NPC-jakobmoenster/Kaboom_Box/KiCad/Kaboom_box.kicad_pcb

## KiCad design KiCad/Kaboom_box.kicad_pcb (2023-12-14)

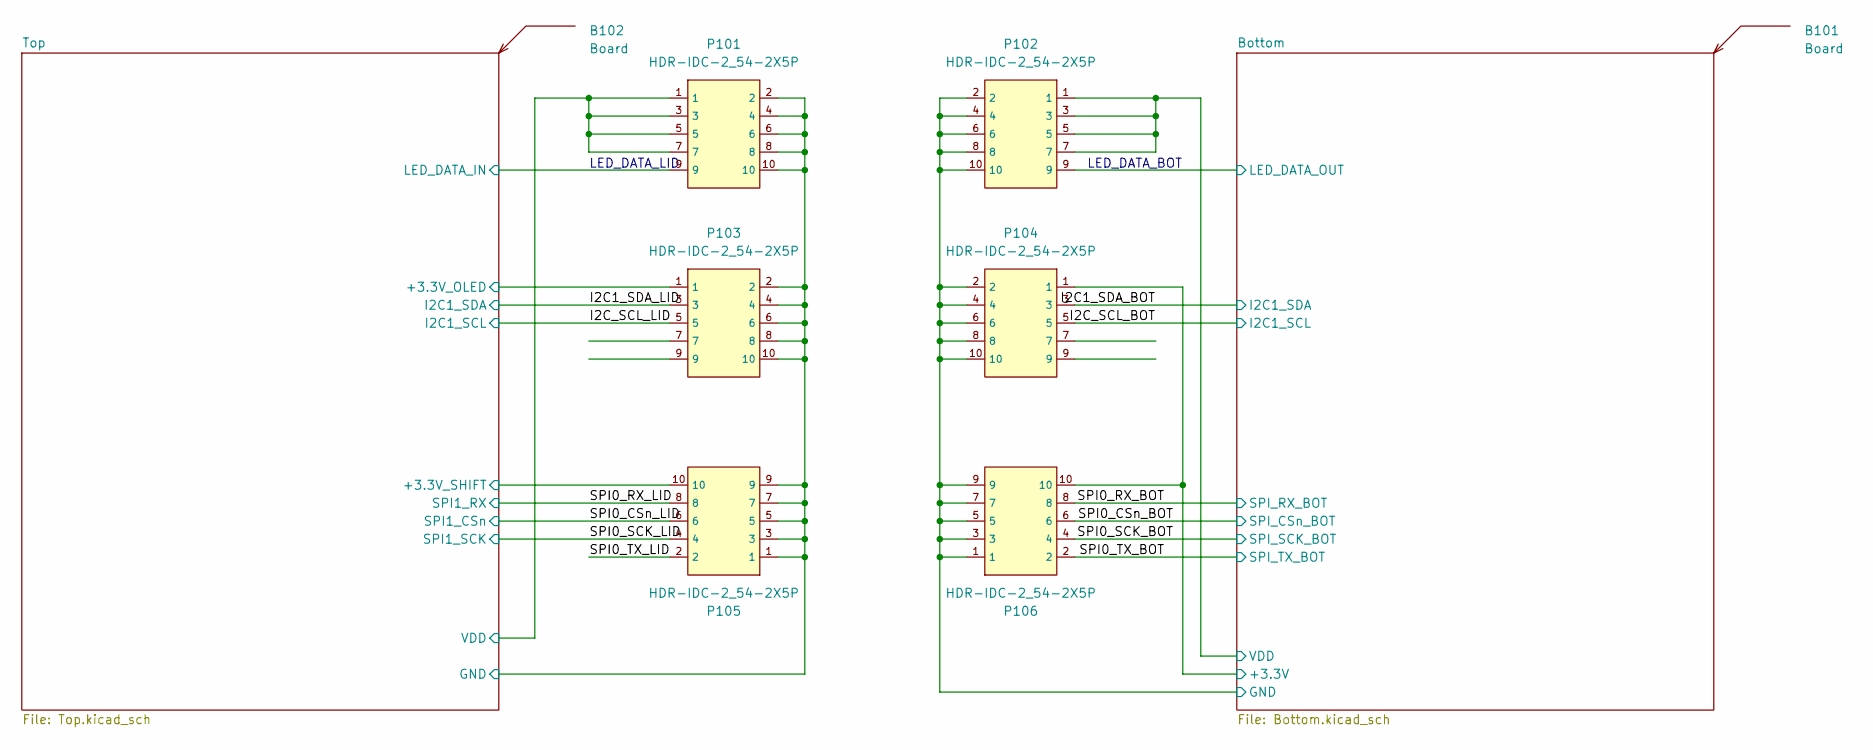
[picture p1: schematic Kaboom_box.kicad_sch]

Parts:
B101, B102: Board
P101, P102, P103, P104, P105, P106: HDR-IDC-2_54-2X5P; IDC-TH_10P-P2.54_C5665; LCSC C5665

Connections:
/Bottom/+3.3V: P104.1, P106.10; also elsewhere on the board
/Bottom/LED_DATA_OUT: P102.9; also elsewhere on the board
/Bottom/VDD: P102.1, P102.3, P102.5, P102.7; also elsewhere on the board
/I2C1_SDA_BOT: P104.3; also elsewhere on the board
/I2C1_SDA_LID: P103.3; also elsewhere on the board
/I2C_SCL_BOT: P104.5; also elsewhere on the board
/I2C_SCL_LID: P103.5; also elsewhere on the board
/SPI0_CSn_BOT: P106.6; also elsewhere on the board
/SPI0_CSn_LID: P105.6; also elsewhere on the board
/SPI0_RX_BOT: P106.8; also elsewhere on the board
/SPI0_RX_LID: P105.8; also elsewhere on the board
/SPI0_SCK_BOT: P106.4; also elsewhere on the board
/SPI0_SCK_LID: P105.4; also elsewhere on the board
/SPI0_TX_BOT: P106.2; also elsewhere on the board
/SPI0_TX_LID: P105.2
/Top/+3.3V_OLED: P103.1; also elsewhere on the board
/Top/+3.3V_SHIFT: P105.10; also elsewhere on the board
/Top/LED_DATA_IN: P101.9; also elsewhere on the board
/Top/VDD: P101.1, P101.3, P101.5, P101.7; also elsewhere on the board

Notes on the sheet:
LED_DATA_BOT
LED_DATA_LID

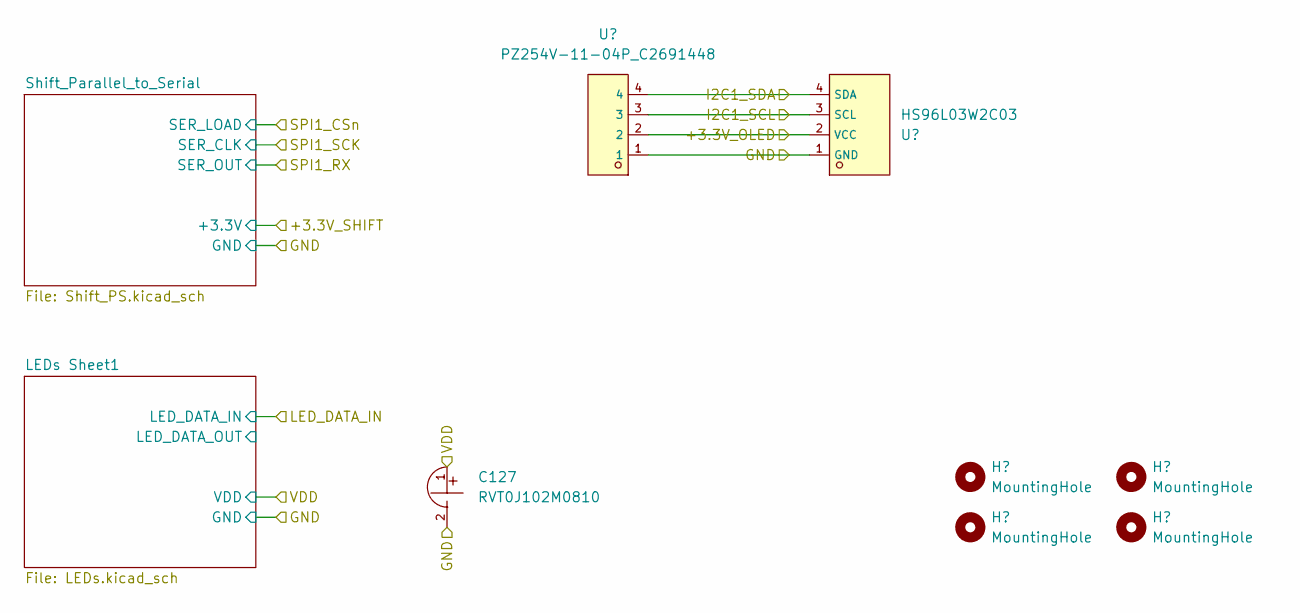
[picture p2: schematic Top.kicad_sch]

Parts:
C127: RVT0J102M0810; CAP-SMD_BD8.0-L8.3-W8.3-FD; LCSC C42851
H101, H102, H103, H104: MountingHole; MountingHole_4.3mm_M4
U143: PZ254V-11-04P_C2691448; HDR-TH_4P-P2.54-V-M; LCSC C2691448
U144: HS96L03W2C03; OLED-TH_L27.8-W27.2-P2.54_C9900033791; LCSC C5248080

Connections:
/Bottom/VDD: C127.1; also elsewhere on the board
/I2C1_SDA_LID: U143.4, U144.4 (SDA); also elsewhere on the board
/I2C_SCL_LID: U143.3, U144.3 (SCL); also elsewhere on the board
/Top/+3.3V_OLED: U143.2, U144.2 (VCC); also elsewhere on the board

Parts of its further copies:
C128: RVT0J102M0810; CAP-SMD_BD8.0-L8.3-W8.3-FD; LCSC C42851
H105, H106, H107, H108: MountingHole; MountingHole_4.3mm_M4

Connections of its further copies:
/Top/VDD: C128.1; also elsewhere on the board

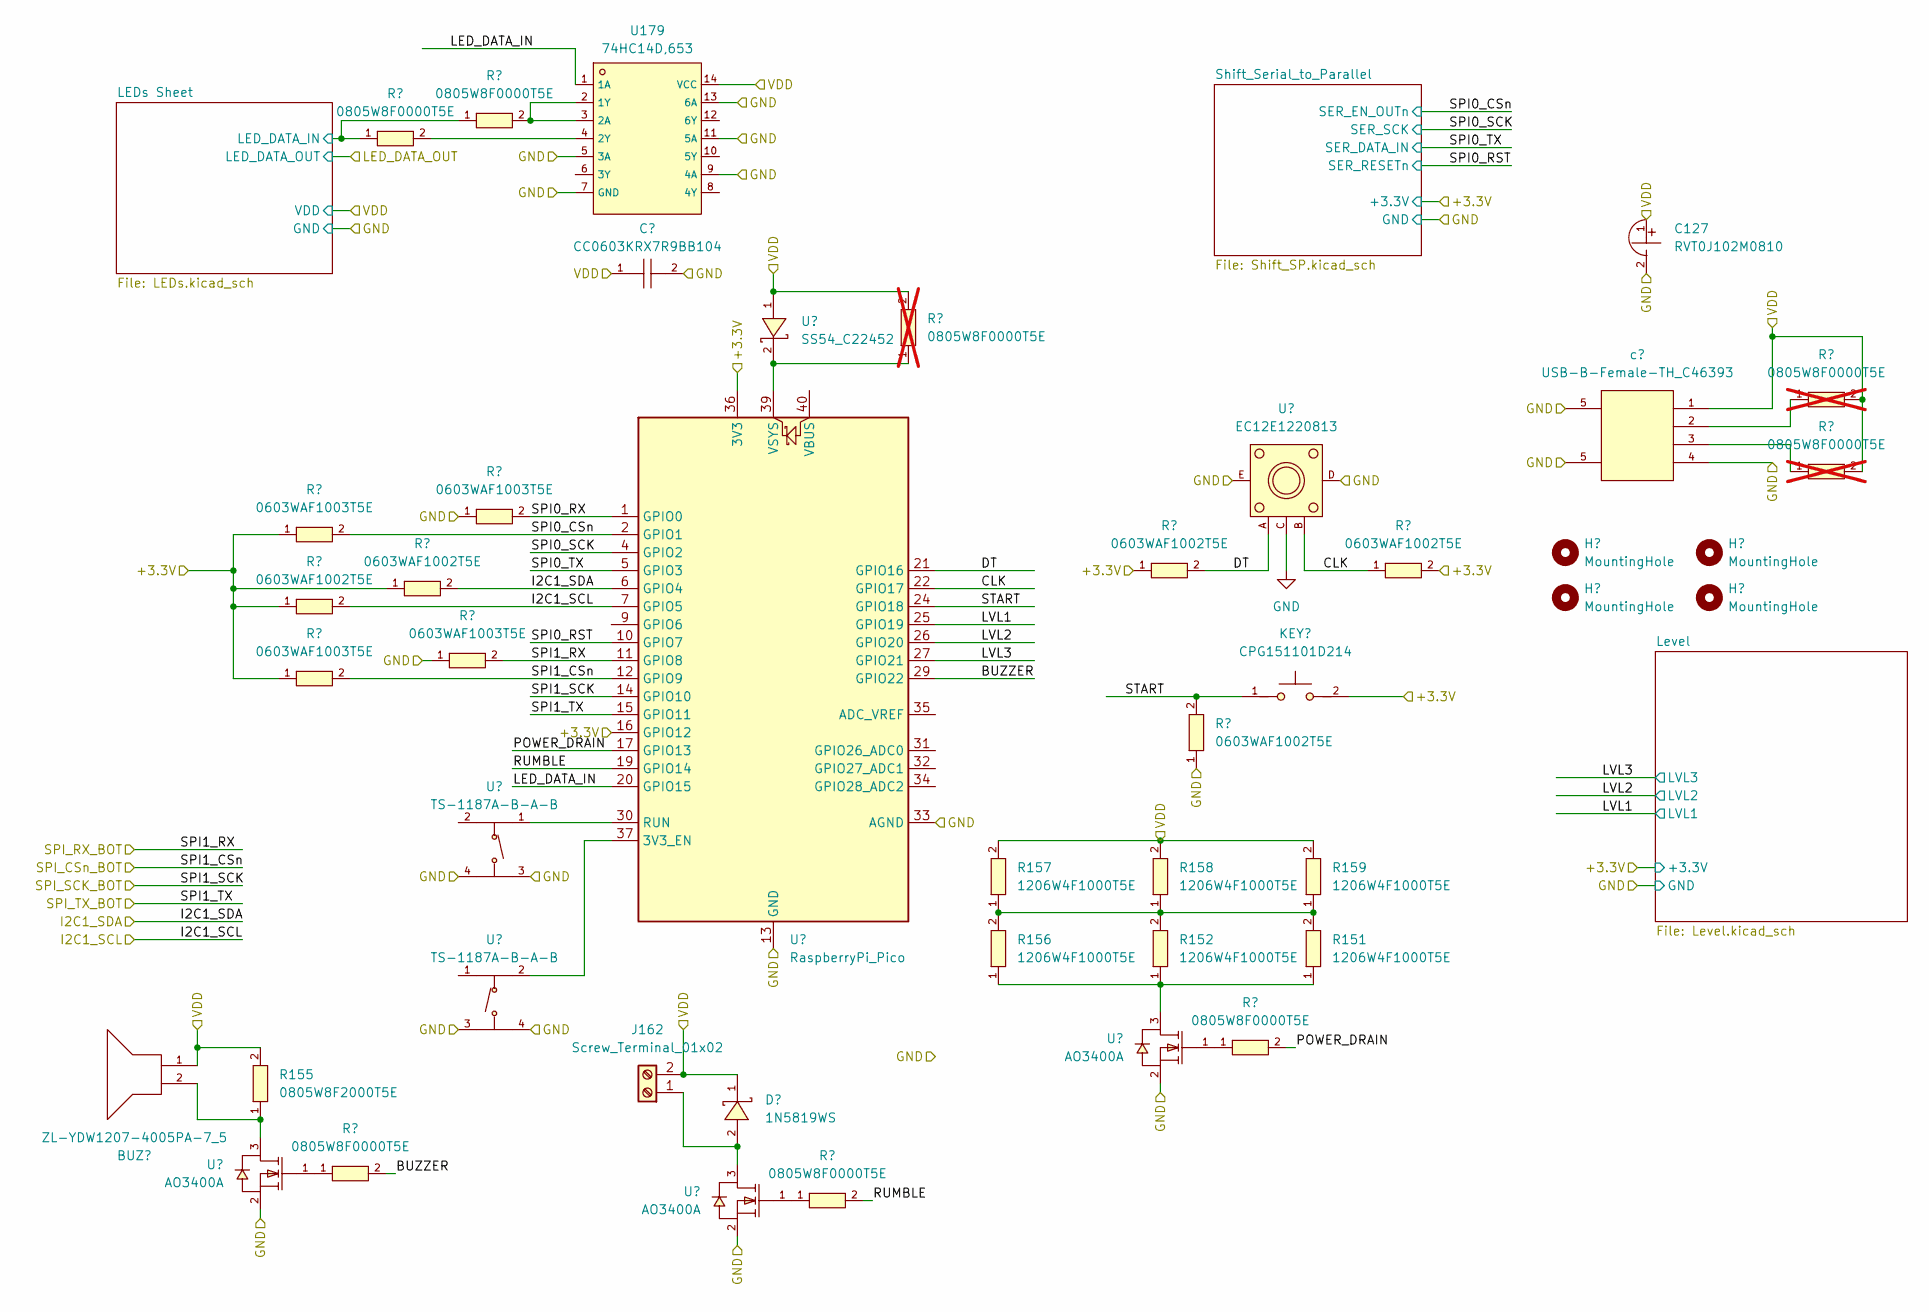
[picture p3: schematic Bottom.kicad_sch]

Parts:
BUZ101: ZL-YDW1207-4005PA-7_5; BUZ-TH_BD12.6-P7.50-D0.9; LCSC C219725
C127: RVT0J102M0810; CAP-SMD_BD8.0-L8.3-W8.3-FD; LCSC C42851
C129: CC0603KRX7R9BB104; C0603; LCSC C14663
D102: 1N5819WS; SOD-323_L1.8-W1.3-LS2.5-RD; LCSC C191023
H101, H102, H103, H104: MountingHole; MountingHole_4.3mm_M4
J162: Screw_Terminal_01x02; TerminalBlock_Phoenix_MKDS-1,5-2_1x02_P5.00mm_Horizontal
KEY101: CPG151101D214; KEY-TH_CPG151101D21X; LCSC C400232
R101, R102, R103: 0805W8F0000T5E; R0805; LCSC C17477; not fitted
R104, R105, R110, R111: 0603WAF1003T5E; R0603; LCSC C25803
R106, R107, R108, R109, R112: 0603WAF1002T5E; R0603; LCSC C25804
R113, R120, R150, R153, R154: 0805W8F0000T5E; R0805; LCSC C17477
R151, R152, R156, R157, R158, R159: 1206W4F1000T5E; R1206; LCSC C17901
R155: 0805W8F2000T5E; R0805; LCSC C17540
U101: SS54_C22452; SMA_L4.4-W2.8-LS5.4-R-RD; LCSC C22452
U102: EC12E1220813; SW-TH_EC12E1220813; LCSC C129727
U103: RaspberryPi_Pico; RaspberryPi_Pico_Common_No_Keepout
U104, U105: TS-1187A-B-A-B; SW-SMD_4P-L5.1-W5.1-P3.70-LS6.5-TL-2; LCSC C318884
U106, U149, U180: AO3400A; SOT-23-3_L2.9-W1.6-P1.90-LS2.8-BR; LCSC C20917
U179: 74HC14D,653; SOIC-14_L8.7-W3.9-P1.27-LS6.0-BL; LCSC C5605
c108: USB-B-Female-TH_C46393; USB-B_TH_BF90; LCSC C46393

Connections:
/Bottom/+3.3V: KEY101.2, R105.1, R106.1, R107.2, R108.1, R109.1, R111.1, U103.16 (GPIO12), U103.36 (3V3); also elsewhere on the board
/Bottom/BUZZER: R113.2, U103.29 (GPIO22)
/Bottom/CLK: R107.1, U102.B, U103.22 (GPIO17)
/Bottom/DT: R106.2, U102.A, U103.21 (GPIO16)
/Bottom/LED_DATA_IN: U103.20 (GPIO15), U179.1 (1A)
/Bottom/LEDs Sheet/LED_DATA_IN: R153.1, R154.1; also elsewhere on the board
/Bottom/LVL1: U103.25 (GPIO19); also elsewhere on the board
/Bottom/LVL2: U103.26 (GPIO20); also elsewhere on the board
/Bottom/LVL3: U103.27 (GPIO21); also elsewhere on the board
/Bottom/POWER_DRAIN: R150.2, U103.17 (GPIO13)
/Bottom/RUMBLE: R120.2, U103.19 (GPIO14)
/Bottom/SPI0_CSn: R105.2, U103.2 (GPIO1); also elsewhere on the board
/Bottom/SPI0_RST: U103.10 (GPIO7); also elsewhere on the board
/Bottom/SPI0_RX: R104.2, U103.1 (GPIO0)
/Bottom/SPI0_SCK: U103.4 (GPIO2); also elsewhere on the board
/Bottom/SPI0_TX: U103.5 (GPIO3); also elsewhere on the board
/Bottom/START: KEY101.1, R112.2, U103.24 (GPIO18)
/Bottom/VDD: BUZ101.1, C127.1, C129.1, D102.1 (K), J162.2, R101.2, R102.2, R103.2, R155.2, R157.2, R158.2, R159.2, U101.1 (A), U179.14 (VCC), c108.1 (VCC); also elsewhere on the board
/I2C1_SDA_BOT: R108.2, U103.6 (GPIO4); also elsewhere on the board
/I2C_SCL_BOT: R109.2, U103.7 (GPIO5); also elsewhere on the board
/SPI0_CSn_BOT: R111.2, U103.12 (GPIO9); also elsewhere on the board
/SPI0_RX_BOT: R110.2, U103.11 (GPIO8); also elsewhere on the board
/SPI0_SCK_BOT: U103.14 (GPIO10); also elsewhere on the board
/SPI0_TX_BOT: U103.15 (GPIO11); also elsewhere on the board
unnamed: D102.2 (A), J162.1, U149.3 (D)
unnamed: R151.2, R152.2, R156.2, R157.1, R158.1, R159.1
unnamed: R101.1, U101.2 (K), U103.39 (VSYS)
unnamed: U103.37 (3V3_EN), U105.2 (B)
unnamed: U103.30 (RUN), U104.1 (A)
unnamed: BUZ101.2, R155.1, U106.3 (D)
unnamed: R113.1, U106.1 (G)
unnamed: R120.1, U149.1 (G)
unnamed: R154.2, U179.2 (1Y), U179.3 (2A)
unnamed: R153.2, U179.4 (2Y)
unnamed: R151.1, R152.1, R156.1, U180.3 (D)
unnamed: R150.1, U180.1 (G)
unnamed: R103.1, c108.3 (D+)
unnamed: R102.1, c108.2 (D-)

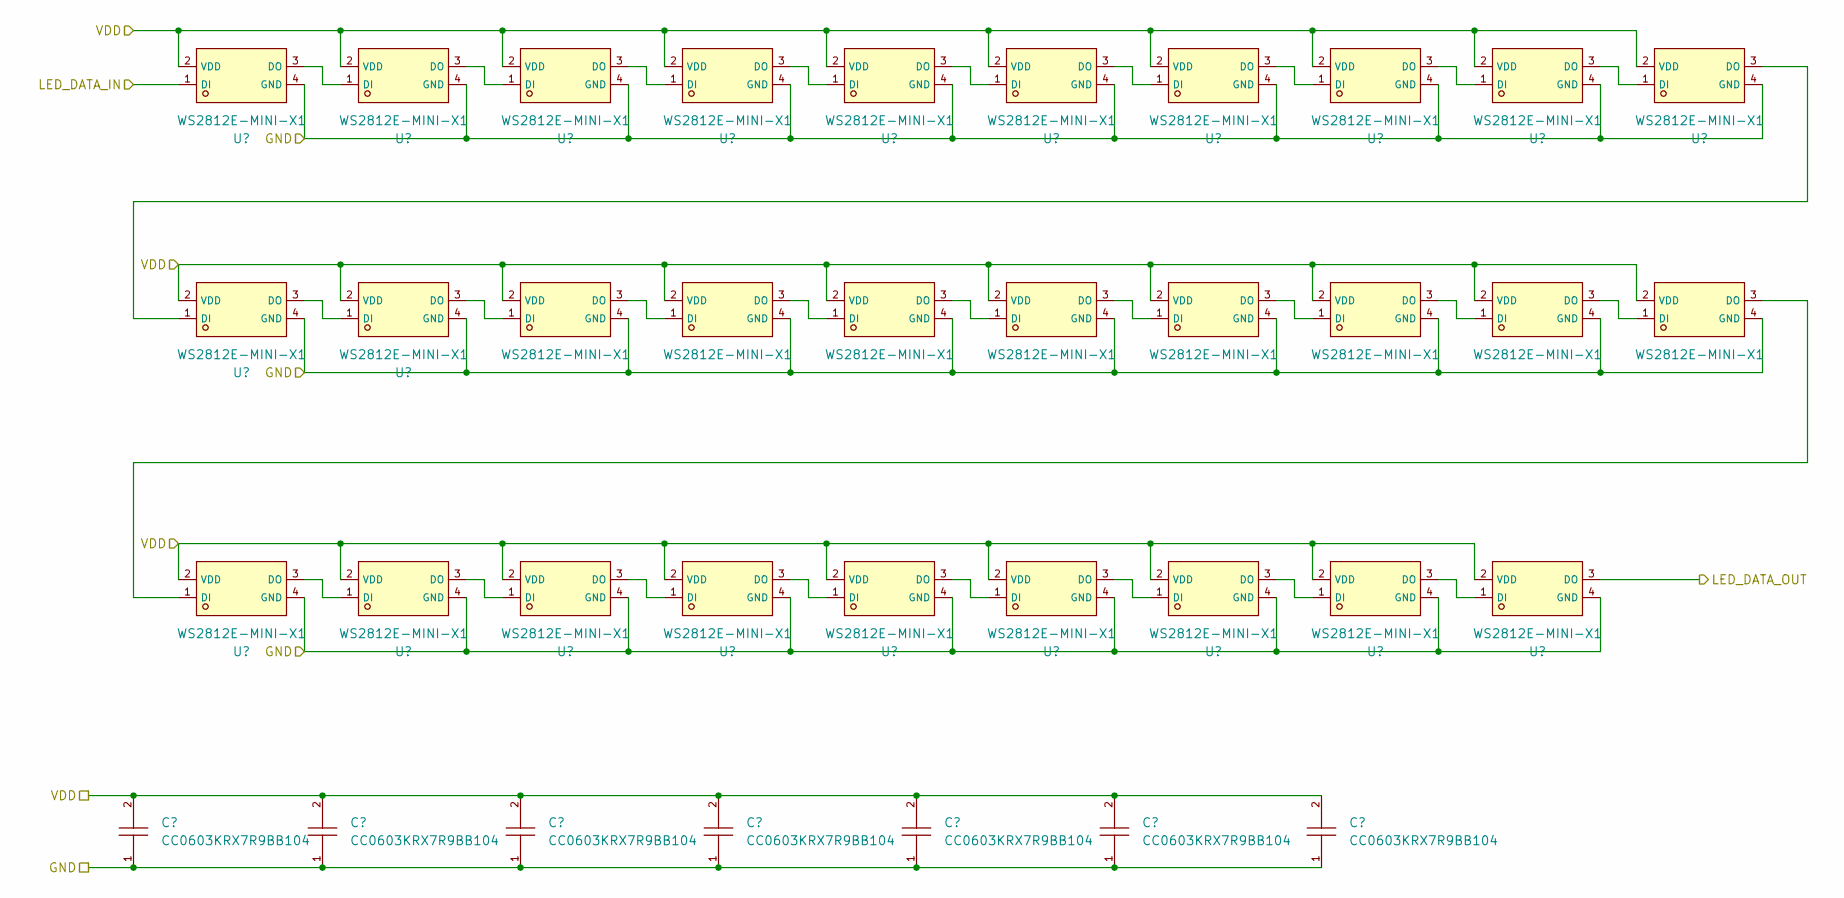
[picture p4: schematic LEDs.kicad_sch]

Parts:
C101, C102, C103, C104, C105, C106, C107: CC0603KRX7R9BB104; C0603; LCSC C14663
U107, U108, U109, U110, U111, U112, U113, U114, U115, U116, U117, U118, U119, U120, U121, U122, U123, U124, U125, U126, U127, U128, U129, U130, U131, U132, U133, U134, U135: WS2812E-MINI-X1; LED-SMD_4P-L3.7-W3.5-P1.75-BR-SK6812MINI; LCSC C4154871

Connections:
/Bottom/LED_DATA_OUT: U135.3 (DO); also elsewhere on the board
/Bottom/LEDs Sheet/LED_DATA_IN: U107.1 (DI); also elsewhere on the board
/Bottom/VDD: C101.2, C102.2, C103.2, C104.2, C105.2, C106.2, C107.2, U107.2 (VDD), U108.2 (VDD), U109.2 (VDD), U110.2 (VDD), U111.2 (VDD), U112.2 (VDD), U113.2 (VDD), U114.2 (VDD), U115.2 (VDD), U116.2 (VDD), U117.2 (VDD), U118.2 (VDD), U119.2 (VDD), U120.2 (VDD), U121.2 (VDD), U122.2 (VDD), U123.2 (VDD), U124.2 (VDD), U125.2 (VDD), U126.2 (VDD), U127.2 (VDD), U128.2 (VDD), U129.2 (VDD), U130.2 (VDD), U131.2 (VDD), U132.2 (VDD), U133.2 (VDD), U134.2 (VDD), U135.2 (VDD); also elsewhere on the board
unnamed: U107.3 (DO), U108.1 (DI)
unnamed: U108.3 (DO), U109.1 (DI)
unnamed: U109.3 (DO), U110.1 (DI)
unnamed: U110.3 (DO), U111.1 (DI)
unnamed: U111.3 (DO), U112.1 (DI)
unnamed: U112.3 (DO), U113.1 (DI)
unnamed: U113.3 (DO), U114.1 (DI)
unnamed: U114.3 (DO), U115.1 (DI)
unnamed: U115.3 (DO), U116.1 (DI)
unnamed: U116.3 (DO), U117.1 (DI)
unnamed: U117.3 (DO), U118.1 (DI)
unnamed: U118.3 (DO), U119.1 (DI)
unnamed: U119.3 (DO), U120.1 (DI)
unnamed: U120.3 (DO), U121.1 (DI)
unnamed: U121.3 (DO), U122.1 (DI)
unnamed: U122.3 (DO), U123.1 (DI)
unnamed: U123.3 (DO), U124.1 (DI)
unnamed: U124.3 (DO), U125.1 (DI)
unnamed: U125.3 (DO), U126.1 (DI)
unnamed: U126.3 (DO), U127.1 (DI)
unnamed: U127.3 (DO), U128.1 (DI)
unnamed: U128.3 (DO), U129.1 (DI)
unnamed: U129.3 (DO), U130.1 (DI)
unnamed: U130.3 (DO), U131.1 (DI)
unnamed: U131.3 (DO), U132.1 (DI)
unnamed: U132.3 (DO), U133.1 (DI)
unnamed: U133.3 (DO), U134.1 (DI)
unnamed: U134.3 (DO), U135.1 (DI)

Parts of its further copies:
C120, C121, C122, C123, C124, C125, C126: CC0603KRX7R9BB104; C0603; LCSC C14663
U150, U151, U152, U153, U154, U155, U156, U157, U158, U159, U160, U161, U162, U163, U164, U165, U166, U167, U168, U169, U170, U171, U172, U173, U174, U175, U176, U177, U178: WS2812E-MINI-X1; LED-SMD_4P-L3.7-W3.5-P1.75-BR-SK6812MINI; LCSC C4154871

Connections of its further copies:
/Top/LED_DATA_IN: U150.1 (DI); also elsewhere on the board
/Top/LEDs Sheet1/LED_DATA_OUT: U178.3 (DO)
/Top/VDD: C120.2, C121.2, C122.2, C123.2, C124.2, C125.2, C126.2, U150.2 (VDD), U151.2 (VDD), U152.2 (VDD), U153.2 (VDD), U154.2 (VDD), U155.2 (VDD), U156.2 (VDD), U157.2 (VDD), U158.2 (VDD), U159.2 (VDD), U160.2 (VDD), U161.2 (VDD), U162.2 (VDD), U163.2 (VDD), U164.2 (VDD), U165.2 (VDD), U166.2 (VDD), U167.2 (VDD), U168.2 (VDD), U169.2 (VDD), U170.2 (VDD), U171.2 (VDD), U172.2 (VDD), U173.2 (VDD), U174.2 (VDD), U175.2 (VDD), U176.2 (VDD), U177.2 (VDD), U178.2 (VDD); also elsewhere on the board
unnamed: U150.3 (DO), U151.1 (DI)
unnamed: U151.3 (DO), U152.1 (DI)
unnamed: U152.3 (DO), U153.1 (DI)
unnamed: U153.3 (DO), U154.1 (DI)
unnamed: U154.3 (DO), U155.1 (DI)
unnamed: U155.3 (DO), U156.1 (DI)
unnamed: U156.3 (DO), U157.1 (DI)
unnamed: U157.3 (DO), U158.1 (DI)
unnamed: U158.3 (DO), U159.1 (DI)
unnamed: U159.3 (DO), U160.1 (DI)
unnamed: U160.3 (DO), U161.1 (DI)
unnamed: U161.3 (DO), U162.1 (DI)
unnamed: U162.3 (DO), U163.1 (DI)
unnamed: U163.3 (DO), U164.1 (DI)
unnamed: U164.3 (DO), U165.1 (DI)
unnamed: U165.3 (DO), U166.1 (DI)
unnamed: U166.3 (DO), U167.1 (DI)
unnamed: U167.3 (DO), U168.1 (DI)
unnamed: U168.3 (DO), U169.1 (DI)
unnamed: U169.3 (DO), U170.1 (DI)
unnamed: U170.3 (DO), U171.1 (DI)
unnamed: U171.3 (DO), U172.1 (DI)
unnamed: U172.3 (DO), U173.1 (DI)
unnamed: U173.3 (DO), U174.1 (DI)
unnamed: U174.3 (DO), U175.1 (DI)
unnamed: U175.3 (DO), U176.1 (DI)
unnamed: U176.3 (DO), U177.1 (DI)
unnamed: U177.3 (DO), U178.1 (DI)

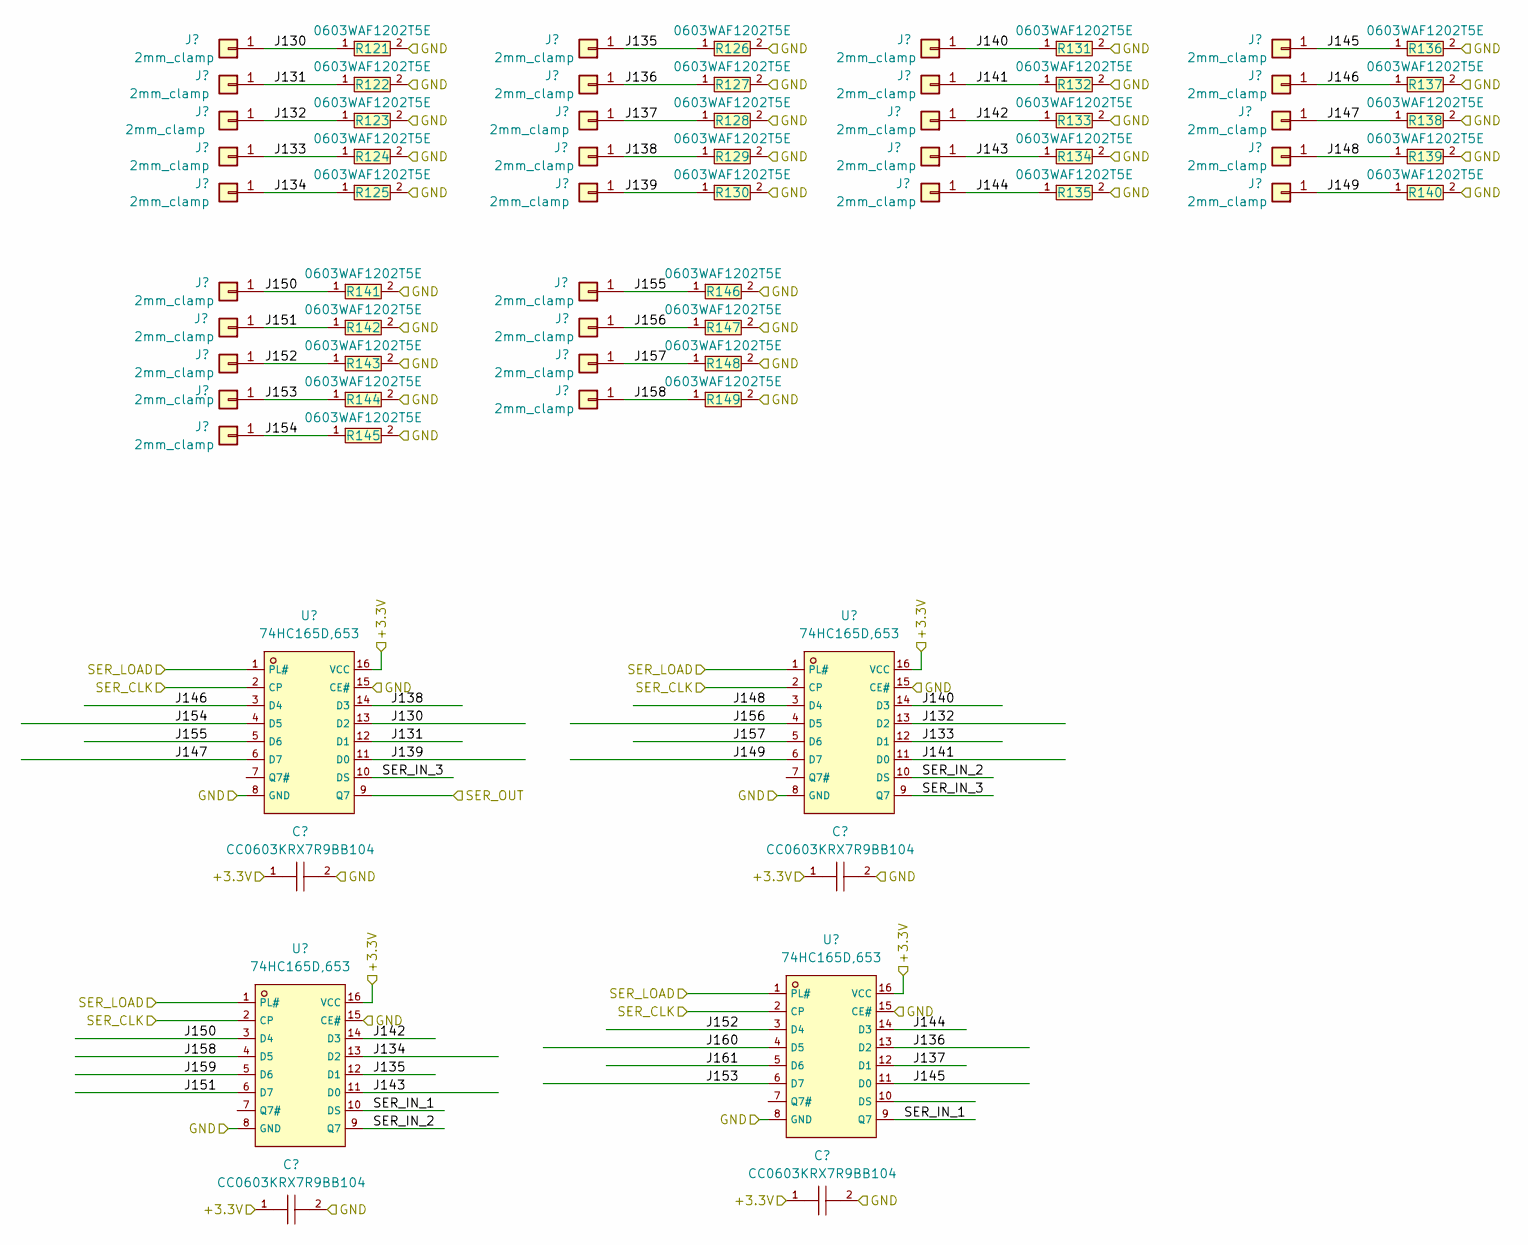
[picture p5: schematic Shift_PS.kicad_sch]

Parts:
C116, C117, C118, C119: CC0603KRX7R9BB104; C0603; LCSC C14663
J130, J131, J132, J133, J134, J135, J136, J137, J138, J139, J140, J141, J142, J143, J144, J145, J146, J147, J148, J149, J150, J151, J152, J153, J154, J155, J156, J157, J158: 2mm_clamp; 2mm testlead, screw-clamp
R121, R122, R123, R124, R125, R126, R127, R128, R129, R130, R131, R132, R133, R134, R135, R136, R137, R138, R139, R140, R141, R142, R143, R144, R145, R146, R147, R148, R149: 0603WAF1202T5E; R0603; LCSC C22790
U145, U146, U147, U148: 74HC165D,653; SOIC-16_L9.9-W3.9-P1.27-LS6.0-BL; LCSC C5613

Connections:
/SPI0_CSn_LID: U145.1 (PL#), U146.1 (PL#), U147.1 (PL#), U148.1 (PL#); also elsewhere on the board
/SPI0_RX_LID: U145.9 (Q7); also elsewhere on the board
/SPI0_SCK_LID: U145.2 (CP), U146.2 (CP), U147.2 (CP), U148.2 (CP); also elsewhere on the board
/Top/+3.3V_SHIFT: C116.1, C117.1, C118.1, C119.1, U145.16 (VCC), U146.16 (VCC), U147.16 (VCC), U148.16 (VCC); also elsewhere on the board
/Top/Shift_Parallel_to_Serial/J130: J130.1, R121.1, U145.13 (D2)
/Top/Shift_Parallel_to_Serial/J131: J131.1, R122.1, U145.12 (D1)
/Top/Shift_Parallel_to_Serial/J132: J132.1, R123.1, U146.13 (D2)
/Top/Shift_Parallel_to_Serial/J133: J133.1, R124.1, U146.12 (D1)
/Top/Shift_Parallel_to_Serial/J134: J134.1, R125.1, U147.13 (D2)
/Top/Shift_Parallel_to_Serial/J135: J135.1, R126.1, U147.12 (D1)
/Top/Shift_Parallel_to_Serial/J136: J136.1, R127.1, U148.13 (D2)
/Top/Shift_Parallel_to_Serial/J137: J137.1, R128.1, U148.12 (D1)
/Top/Shift_Parallel_to_Serial/J138: J138.1, R129.1, U145.14 (D3)
/Top/Shift_Parallel_to_Serial/J139: J139.1, R130.1, U145.11 (D0)
/Top/Shift_Parallel_to_Serial/J140: J140.1, R131.1, U146.14 (D3)
/Top/Shift_Parallel_to_Serial/J141: J141.1, R132.1, U146.11 (D0)
/Top/Shift_Parallel_to_Serial/J142: J142.1, R133.1, U147.14 (D3)
/Top/Shift_Parallel_to_Serial/J143: J143.1, R134.1, U147.11 (D0)
/Top/Shift_Parallel_to_Serial/J144: J144.1, R135.1, U148.14 (D3)
/Top/Shift_Parallel_to_Serial/J145: J145.1, R136.1, U148.11 (D0)
/Top/Shift_Parallel_to_Serial/J146: J146.1, R137.1, U145.3 (D4)
/Top/Shift_Parallel_to_Serial/J147: J147.1, R138.1, U145.6 (D7)
/Top/Shift_Parallel_to_Serial/J148: J148.1, R139.1, U146.3 (D4)
/Top/Shift_Parallel_to_Serial/J149: J149.1, R140.1, U146.6 (D7)
/Top/Shift_Parallel_to_Serial/J150: J150.1, R141.1, U147.3 (D4)
/Top/Shift_Parallel_to_Serial/J151: J151.1, R142.1, U147.6 (D7)
/Top/Shift_Parallel_to_Serial/J152: J152.1, R143.1, U148.3 (D4)
/Top/Shift_Parallel_to_Serial/J153: J153.1, R144.1, U148.6 (D7)
/Top/Shift_Parallel_to_Serial/J154: J154.1, R145.1, U145.4 (D5)
/Top/Shift_Parallel_to_Serial/J155: J155.1, R146.1, U145.5 (D6)
/Top/Shift_Parallel_to_Serial/J156: J156.1, R147.1, U146.4 (D5)
/Top/Shift_Parallel_to_Serial/J157: J157.1, R148.1, U146.5 (D6)
/Top/Shift_Parallel_to_Serial/J158: J158.1, R149.1, U147.4 (D5)
/Top/Shift_Parallel_to_Serial/J159: U147.5 (D6)
/Top/Shift_Parallel_to_Serial/J160: U148.4 (D5)
/Top/Shift_Parallel_to_Serial/J161: U148.5 (D6)
/Top/Shift_Parallel_to_Serial/SER_IN_1: U147.10 (DS), U148.9 (Q7)
/Top/Shift_Parallel_to_Serial/SER_IN_2: U146.10 (DS), U147.9 (Q7)
/Top/Shift_Parallel_to_Serial/SER_IN_3: U145.10 (DS), U146.9 (Q7)

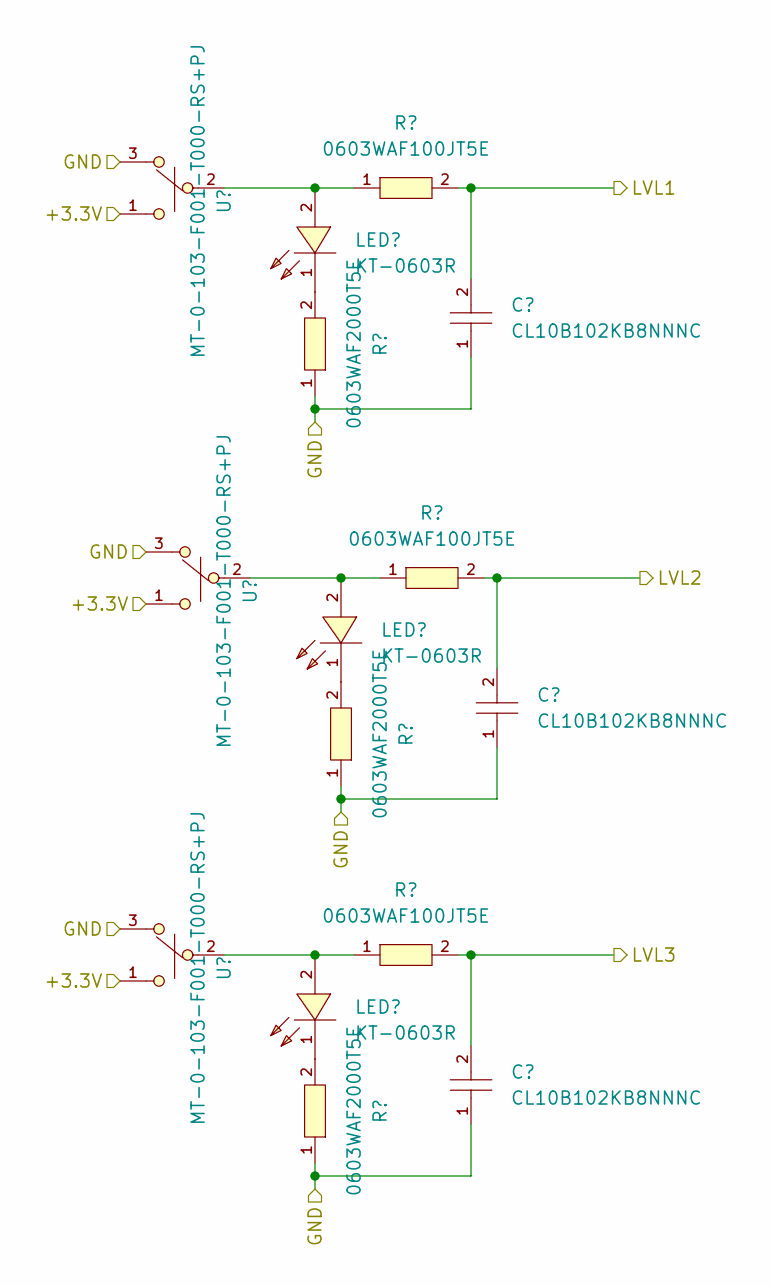
[picture p6: schematic Level.kicad_sch]

Parts:
C113, C114, C115: CL10B102KB8NNNC; C0603; LCSC C1588
LED101, LED102, LED103: KT-0603R; LED0603-RD; LCSC C2286
R114, R116, R118: 0603WAF100JT5E; R0603; LCSC C22859
R115, R117, R119: 0603WAF2000T5E; R0603; LCSC C8218
U140, U141, U142: MT-0-103-F001-T000-RS+PJ; SW-TH_MT-0-103-A101-M200-RS; LCSC C1788498

Connections:
/Bottom/+3.3V: U140.1, U141.1, U142.1; also elsewhere on the board
/Bottom/LVL1: C113.2, R114.2; also elsewhere on the board
/Bottom/LVL2: C114.2, R116.2; also elsewhere on the board
/Bottom/LVL3: C115.2, R118.2; also elsewhere on the board
unnamed: LED101.2 (A), R114.1, U140.2
unnamed: LED101.1 (K), R115.2
unnamed: LED102.2 (A), R116.1, U141.2
unnamed: LED102.1 (K), R117.2
unnamed: LED103.2 (A), R118.1, U142.2
unnamed: LED103.1 (K), R119.2

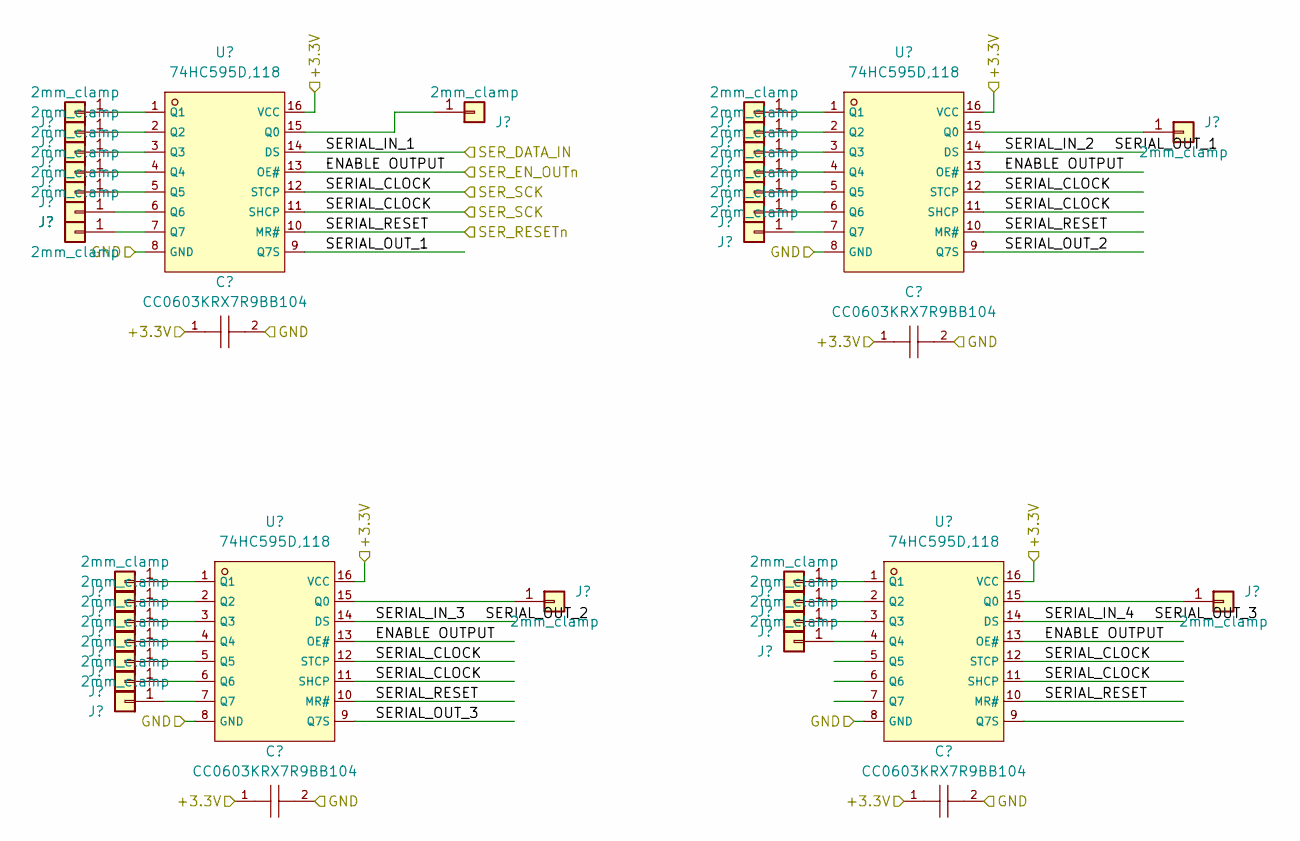
[picture p7: schematic Shift_SP.kicad_sch]

Parts:
C109, C110, C111, C112: CC0603KRX7R9BB104; C0603; LCSC C14663
J101, J102, J103, J104, J105, J106, J107, J108, J109, J110, J111, J112, J113, J114, J115, J116, J117, J118, J119, J120, J121, J122, J123, J124, J125, J126, J127, J128, J129: 2mm_clamp; 2mm testlead, screw-clamp
U136, U137, U138, U139: 74HC595D,118; SOIC-16_L9.9-W3.9-P1.27-LS6.0-BL; LCSC C5947

Connections:
/Bottom/+3.3V: C109.1, C110.1, C111.1, C112.1, U136.16 (VCC), U137.16 (VCC), U138.16 (VCC), U139.16 (VCC); also elsewhere on the board
/Bottom/SPI0_CSn: U136.13 (OE#), U137.13 (OE#), U138.13 (OE#), U139.13 (OE#); also elsewhere on the board
/Bottom/SPI0_RST: U136.10 (MR#), U137.10 (MR#), U138.10 (MR#), U139.10 (MR#); also elsewhere on the board
/Bottom/SPI0_SCK: U136.11 (SHCP), U136.12 (STCP), U137.11 (SHCP), U137.12 (STCP), U138.11 (SHCP), U138.12 (STCP), U139.11 (SHCP), U139.12 (STCP); also elsewhere on the board
/Bottom/SPI0_TX: U136.14 (DS); also elsewhere on the board
/Bottom/Shift_Serial_to_Parallel/SERIAL_IN_2: U136.9 (Q7S), U137.14 (DS)
/Bottom/Shift_Serial_to_Parallel/SERIAL_IN_3: U137.9 (Q7S), U138.14 (DS)
/Bottom/Shift_Serial_to_Parallel/SERIAL_IN_4: U138.9 (Q7S), U139.14 (DS)
unnamed: J101.1, U136.15 (Q0)
unnamed: J102.1, U136.7 (Q7)
unnamed: J103.1, U137.1 (Q1)
unnamed: J104.1, U136.1 (Q1)
unnamed: J105.1, U137.2 (Q2)
unnamed: J106.1, U137.15 (Q0)
unnamed: J107.1, U136.2 (Q2)
unnamed: J108.1, U137.3 (Q3)
unnamed: J109.1, U136.3 (Q3)
unnamed: J110.1, U137.4 (Q4)
unnamed: J111.1, U136.4 (Q4)
unnamed: J112.1, U137.5 (Q5)
unnamed: J113.1, U136.5 (Q5)
unnamed: J114.1, U137.6 (Q6)
unnamed: J115.1, U136.6 (Q6)
unnamed: J116.1, U137.7 (Q7)
unnamed: J117.1, U138.1 (Q1)
unnamed: J118.1, U139.1 (Q1)
unnamed: J119.1, U138.2 (Q2)
unnamed: J120.1, U138.15 (Q0)
unnamed: J121.1, U139.2 (Q2)
unnamed: J122.1, U139.15 (Q0)
unnamed: J123.1, U138.3 (Q3)
unnamed: J124.1, U139.3 (Q3)
unnamed: J125.1, U138.4 (Q4)
unnamed: J126.1, U139.4 (Q4)
unnamed: J127.1, U138.5 (Q5)
unnamed: J128.1, U138.6 (Q6)
unnamed: J129.1, U138.7 (Q7)

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
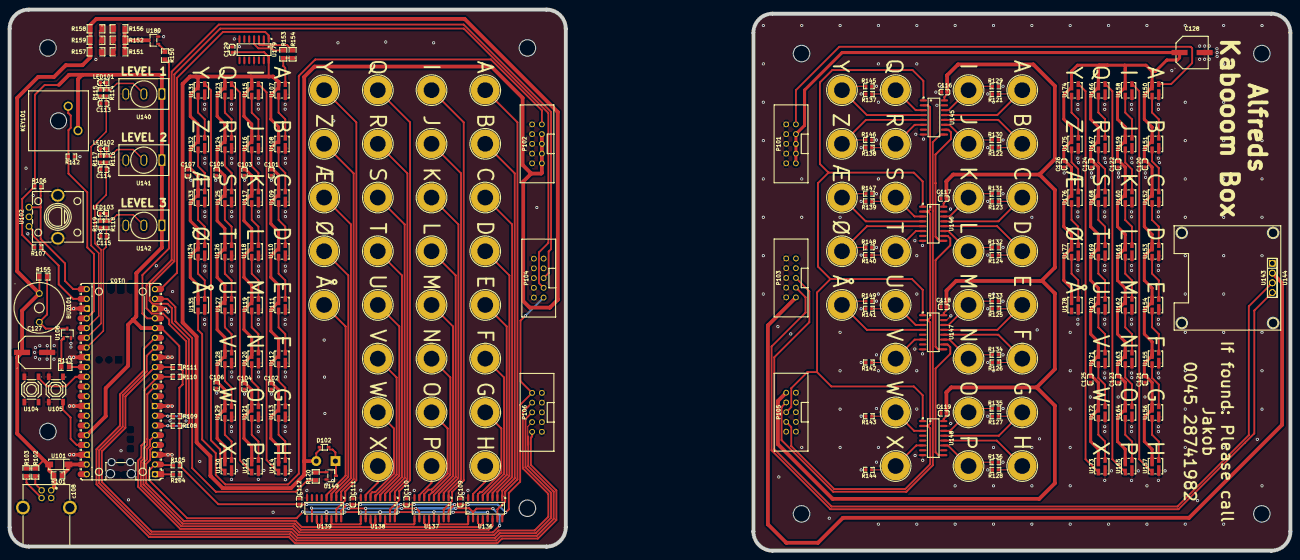
[picture p8: board Kaboom_box.kicad_pcb from above]

Board: 2 copper layers, 333.9 x 141.1 mm, 249 parts (1 on the bottom side), 176 nets.
