NPC-jakobmoenster/Kaboom_Box/(commit log)

2023-09-08 Initial commit of the PCBs - WIP
    [Bottom.kicad_sch, JLCPCB.kicad_pcb, JLCPCB.sch, Kaboom_box.kicad_pcb, Kaboom_box.kicad_sch, LEDs.kicad_sch, Level.kicad_sch, Shift.kicad_sch]
2023-09-08 Update to TOP pcb - 2mm holes placement and routing
    [Kaboom_box.kicad_pcb, Shift_PS.kicad_sch]
2023-09-11 WIP on Bottom
    [Bottom.kicad_sch, Kaboom_box.kicad_pcb]
2023-09-11 Layout wip
    [Bottom.kicad_sch, Kaboom_box.kicad_pcb, Kaboom_box.kicad_sch]
2023-09-13 Ready for review
    [Bottom.kicad_sch, Kaboom_box.kicad_pcb, Kaboom_box.kicad_sch, Shift_PS.kicad_sch, Top.kicad_sch]
2023-09-14 Updated to generate JLCPCB files
    [Bottom.kicad_sch, Kaboom_box.kicad_pcb, Top.kicad_sch]
2023-10-09 PCB V1
    [Bottom.kicad_sch, Kaboom_box.kicad_pcb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]
2023-12-12 First draft done - missing comments
    [flash.py, listen2pico.py, pyboard.py, rotary.py, rotary_irq_rp2.py, ssd1306.py]
2023-12-12 UPdated outline + added pull down resistors on input of shifts
    [Bottom.kicad_sch, Kaboom_box.kicad_pcb, Shift_PS.kicad_sch]
2023-12-14 Updates for V2
    [Bottom.kicad_sch, Kaboom_box.kicad_pcb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]
2024-01-20 Working - encoder can stall program
    [disp_test.py, main.py, ssd1306_setup.py]
2024-05-02 First production
    [Bottom.kicad_sch, Kaboom_box.kicad_sch, LEDs.kicad_sch, Level.kicad_sch, Physical.kicad_sch, RTC.kicad_sch, Shift_PS.kicad_sch, Shift_SP.kicad_sch]
